LautiDO/Electro-FiubaRacing/raspi_config/Conexion SSH.pdf

1.- Ver conexiones de red-> Propiedades

2.- Editar TCP/IPV4

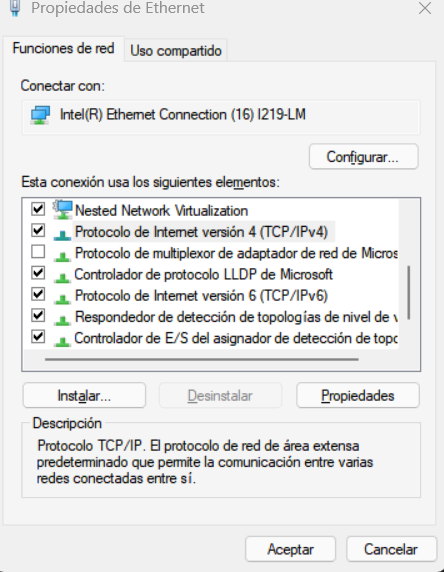
[picture p1: figure]

5.- Colocar las siguientes direcciones

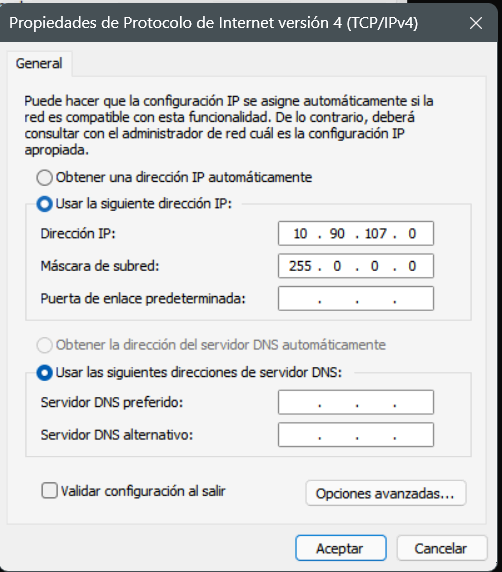
[picture p2: figure]

6.- realizar un ping para confirmar conexión

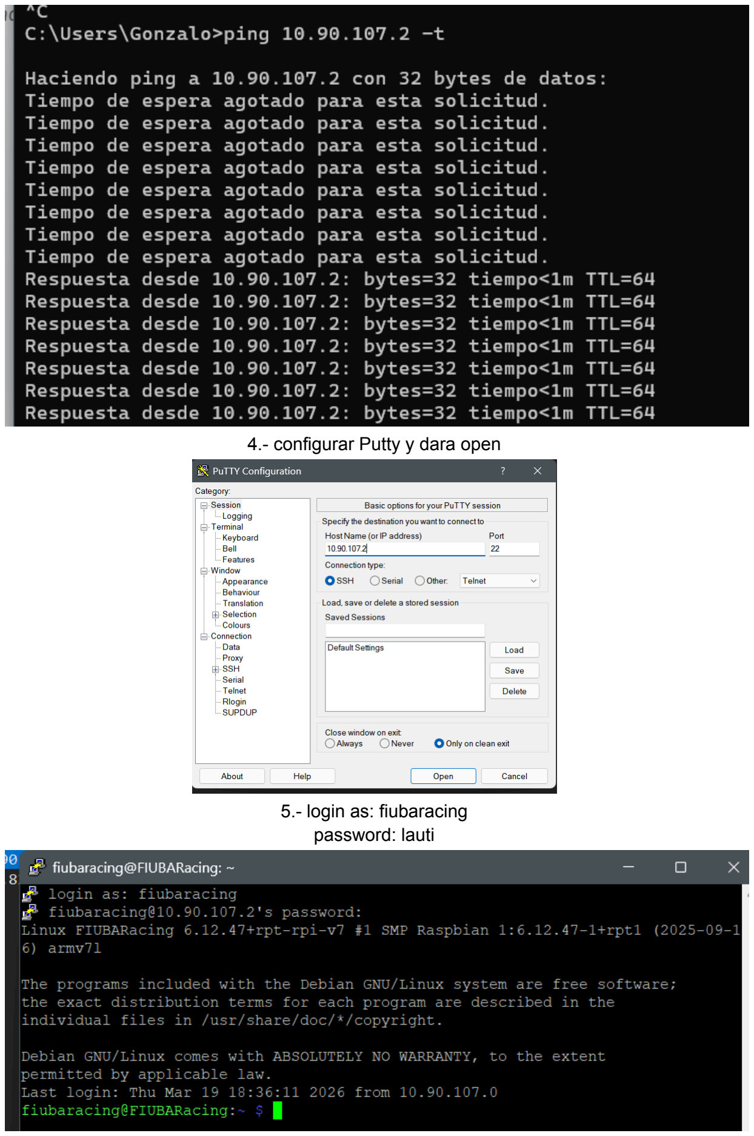
[picture p3: page 2]

4.- configurar Putty y dara open

5.- login as: fiubaracing
password: lauti
