LautiDO/Electro-FiubaRacing/PCB_V5/PCB_V5.kicad_pcb

## KiCad design PCB_V5/PCB_V5.kicad_pcb (2026-08-25)

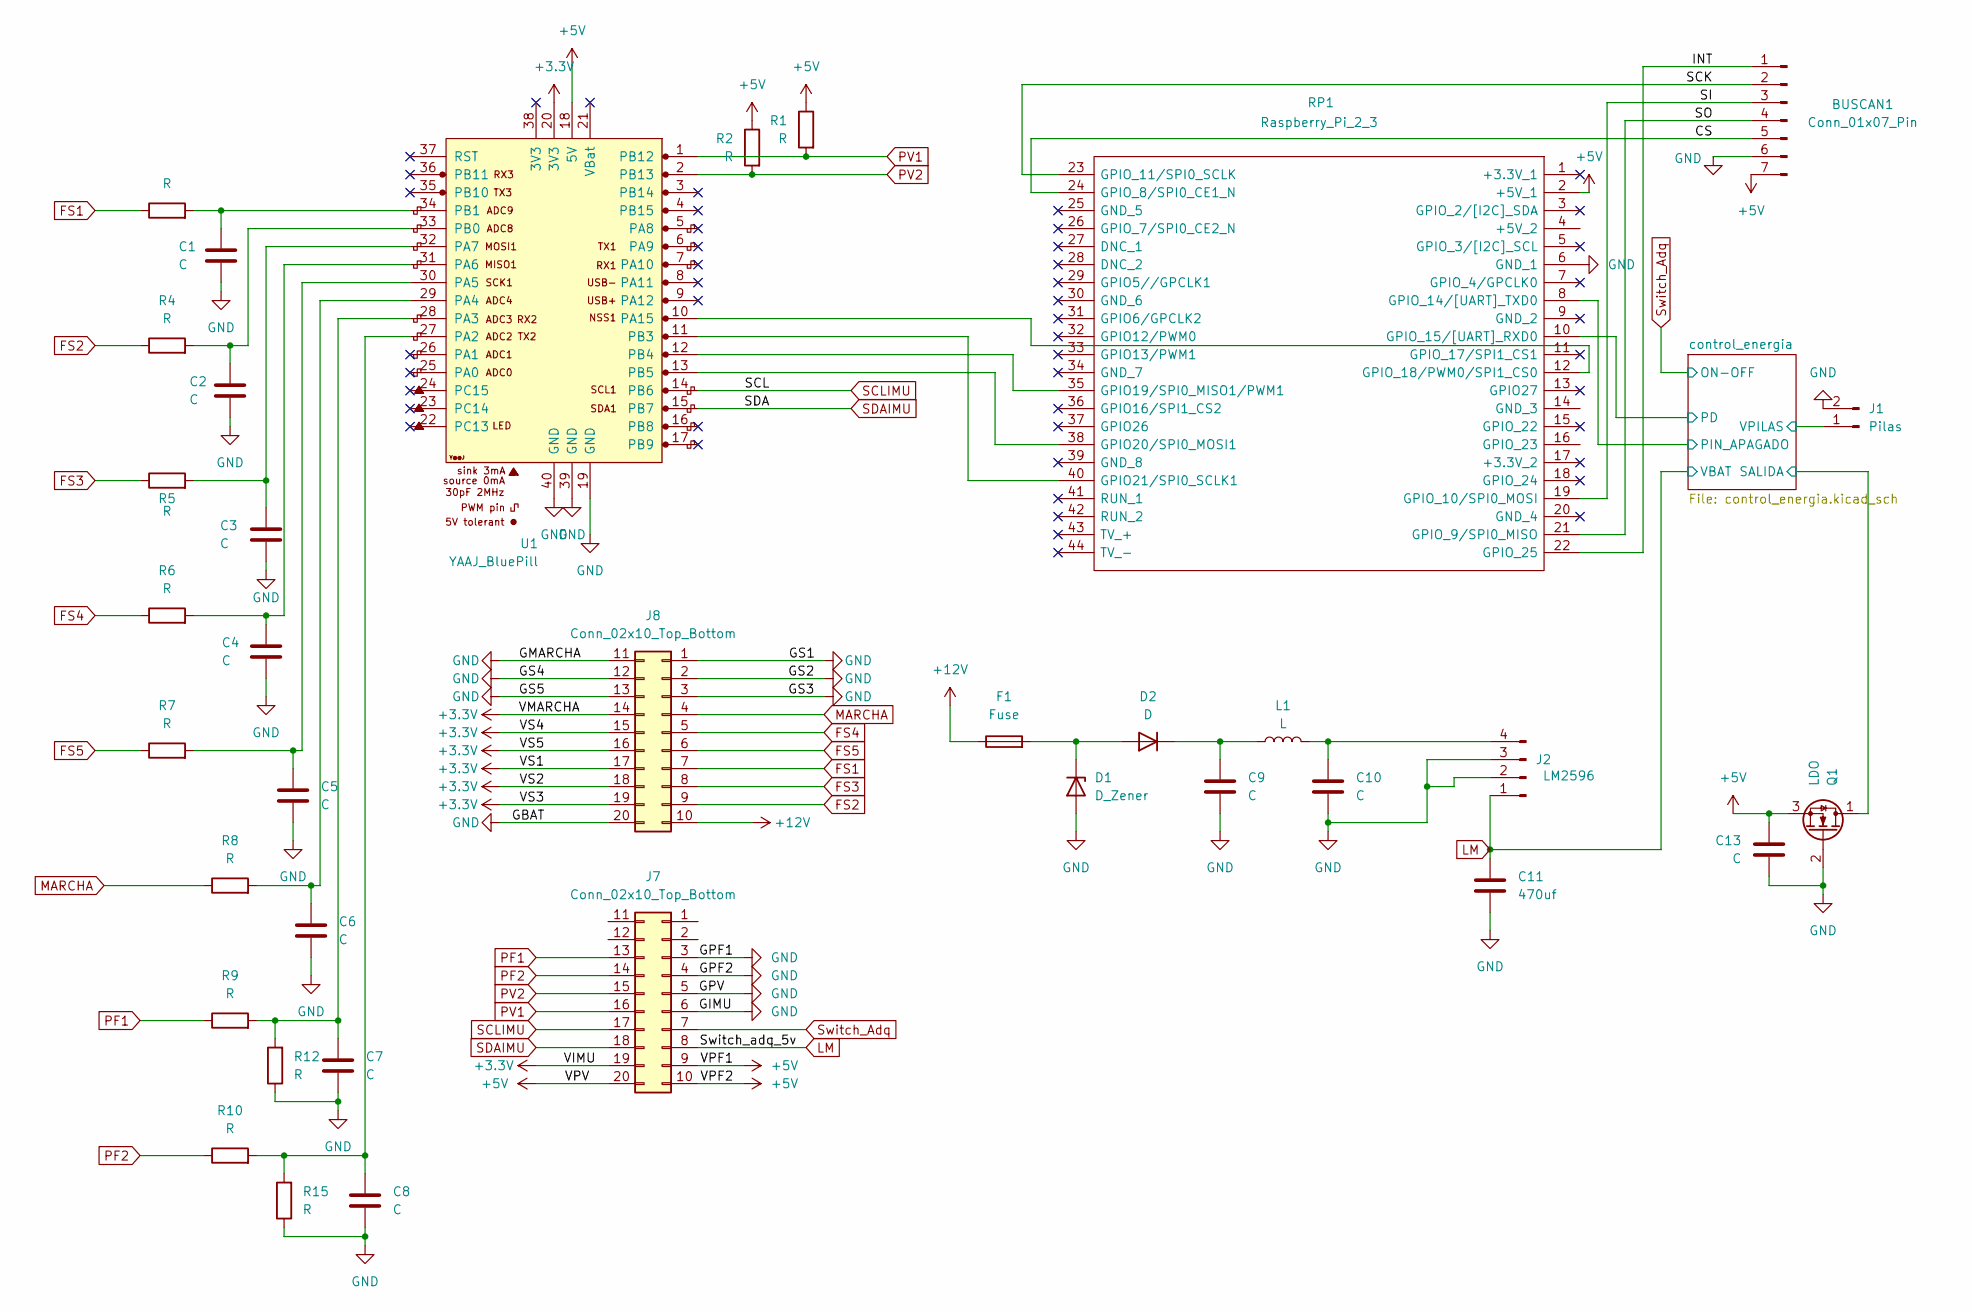
[picture p4: schematic PCB_V5.kicad_sch]

Parts:
BUSCAN1: Conn_01x07_Pin; PinHeader_1x07_P2.54mm_Vertical
C1, C2, C3, C4, C5, C6, C7, C8, C9, C10, C13: C; CP_Radial_D5.0mm_P2.50mm
C11: 470uf; CP_Radial_D5.0mm_P2.50mm
D1: D_Zener; D_DO-201_P15.24mm_Horizontal
D2: D; D_DO-201_P15.24mm_Horizontal
F1: Fuse; Fuseholder_Cylinder-5x20mm_Schurter_0031_8201_Horizontal_Op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
J1: Pilas; TerminalBlock_Phoenix_PT-1,5-2-5.0-H_1x02_P5.00mm_Horizontal
J2: LM2596; PinHeader_1x04_P2.54mm_Vertical
J7, J8: Conn_02x10_Top_Bottom; Molex_Mini-Fit_Jr_5566-20A2_2x10_P4.20mm_Vertical
L1: L; Transformer_CHK_EI38-3VA_Neutral
Q1: LDO; TO-220-3_Vertical
R1, R2, R3, R4, R5, R6, R7, R8, R9, R10, R12, R15: R; R_Axial_DIN0207_L6.3mm_D2.5mm_P7.62mm_Horizontal
RP1: Raspberry_Pi_2_3; PinHeader_2x20_P2.54mm_Vertical; Manufacturer_Part_Number Raspberry Pi 2 or 3
U1: YAAJ_BluePill; PinHeader_2x20_P2.54mm_Vertical

Connections:
+3.3V: J7.19, J8.14, J8.15, J8.16, J8.17, J8.18, J8.19, U1.20 (3V3)
+5V: BUSCAN1.7, C13.1, J7.9, J7.10, J7.20, Q1.3 (S), R1.1, R2.1, RP1.2 (+5V_1), U1.18 (5V)
+12V: F1.1, J8.10
/CS: BUSCAN1.5, RP1.24 (GPIO_8/SPI0_CE1_N)
/INT: BUSCAN1.1, RP1.22 (GPIO_25)
/SCK: BUSCAN1.2, RP1.23 (GPIO_11/SPI0_SCLK)
/SI: BUSCAN1.3, RP1.19 (GPIO_10/SPI0_MOSI)
/SO: BUSCAN1.4, RP1.21 (GPIO_9/SPI0_MISO)
/control_energia/PD: RP1.10 (GPIO_15/[UART]_RXD0); also elsewhere on the board
/control_energia/PIN_APAGADO: RP1.8 (GPIO_14/[UART]_TXD0); also elsewhere on the board
/control_energia/SALIDA: Q1.1 (D); also elsewhere on the board
/control_energia/VPILAS: J1.1; also elsewhere on the board
FS1: J8.7, R3.1
FS2: J8.9, R4.1
FS3: J8.8, R5.1
FS4: J8.5, R6.1
FS5: J8.6, R7.1
GND: BUSCAN1.6, C1.2, C2.2, C3.2, C4.2, C5.2, C6.2, C7.2, C8.2, C9.2, C10.2, C11.2, C13.2, D1.2 (A), J1.2, J2.2, J2.3, J7.3, J7.4, J7.5, J7.6, J8.1, J8.2, J8.3, J8.11, J8.12, J8.13, J8.20, Q1.2 (G), R12.1, R15.1, RP1.6 (GND_1), U1.19 (GND), U1.39 (GND), U1.40 (GND); also elsewhere on the board
LM: C11.1, J2.1, J7.8; also elsewhere on the board
MARCHA: J8.4, R8.1
unnamed: D1.1 (K), D2.2 (A), F1.2
unnamed: C9.1, D2.1 (K), L1.1
unnamed: C10.1, J2.4, L1.2
unnamed: RP1.35 (GPIO19/SPI0_MISO1/PWM1), U1.12 (PB4)
unnamed: RP1.38 (GPIO20/SPI0_MOSI1), U1.13 (PB5)
unnamed: RP1.40 (GPIO21/SPI0_SCLK1), U1.11 (PB3)
unnamed: RP1.12 (GPIO_18/PWM0/SPI1_CS0), U1.10 (PA15)
unnamed: C8.1, R10.2, R15.2, U1.27 (PA2)
unnamed: C7.1, R9.2, R12.2, U1.28 (PA3)
unnamed: C6.1, R8.2, U1.29 (PA4)
unnamed: C5.1, R7.2, U1.30 (PA5)
unnamed: C4.1, R6.2, U1.31 (PA6)
unnamed: C3.1, R5.2, U1.32 (PA7)
unnamed: C2.1, R4.2, U1.33 (PB0)
unnamed: C1.1, R3.2, U1.34 (PB1)
PF1: J7.13, R9.1
PF2: J7.14, R10.1
PV1: J7.16, R1.2, U1.1 (PB12)
PV2: J7.15, R2.2, U1.2 (PB13)
SCLIMU: J7.17, U1.14 (PB6)
SDAIMU: J7.18, U1.15 (PB7)
Switch_Adq: J7.7; also elsewhere on the board

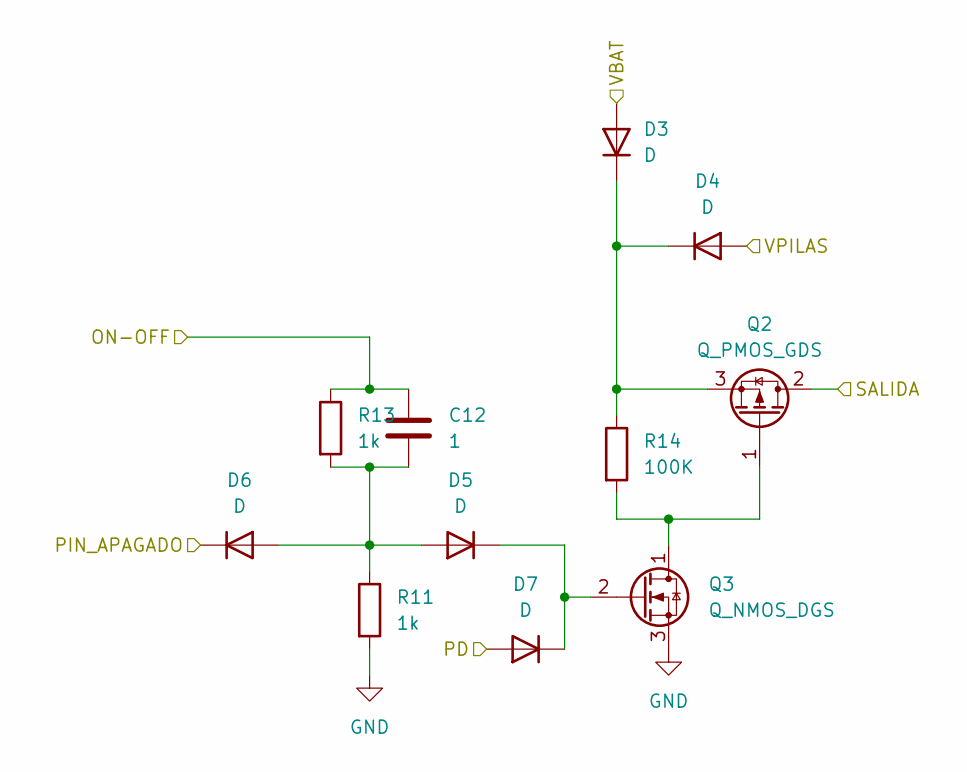
[picture p5: schematic control_energia.kicad_sch]

Parts:
C12: 1; CP_Radial_D5.0mm_P2.50mm
D3, D4, D5, D6, D7: D; R_Axial_DIN0207_L6.3mm_D2.5mm_P7.62mm_Horizontal
Q2: Q_PMOS_GDS; TO-220-3_Vertical
Q3: Q_NMOS_DGS; TO-92_HandSolder
R11, R13: 1k; R_Axial_DIN0207_L6.3mm_D2.5mm_P7.62mm_Horizontal
R14: 100K; R_Axial_DIN0207_L6.3mm_D2.5mm_P7.62mm_Horizontal

Connections:
/control_energia/PD: D7.2 (A); also elsewhere on the board
/control_energia/PIN_APAGADO: D6.1 (K); also elsewhere on the board
/control_energia/SALIDA: Q2.2 (D); also elsewhere on the board
/control_energia/VPILAS: D4.2 (A); also elsewhere on the board
GND: Q3.3 (S), R11.2; also elsewhere on the board
LM: D3.2 (A); also elsewhere on the board
unnamed: D3.1 (K), D4.1 (K), Q2.3 (S), R14.1
unnamed: C12.2, D5.2 (A), D6.2 (A), R11.1, R13.2
unnamed: D5.1 (K), D7.1 (K), Q3.2 (G)
unnamed: Q2.1 (G), Q3.1 (D), R14.2
Switch_Adq: C12.1, R13.1; also elsewhere on the board

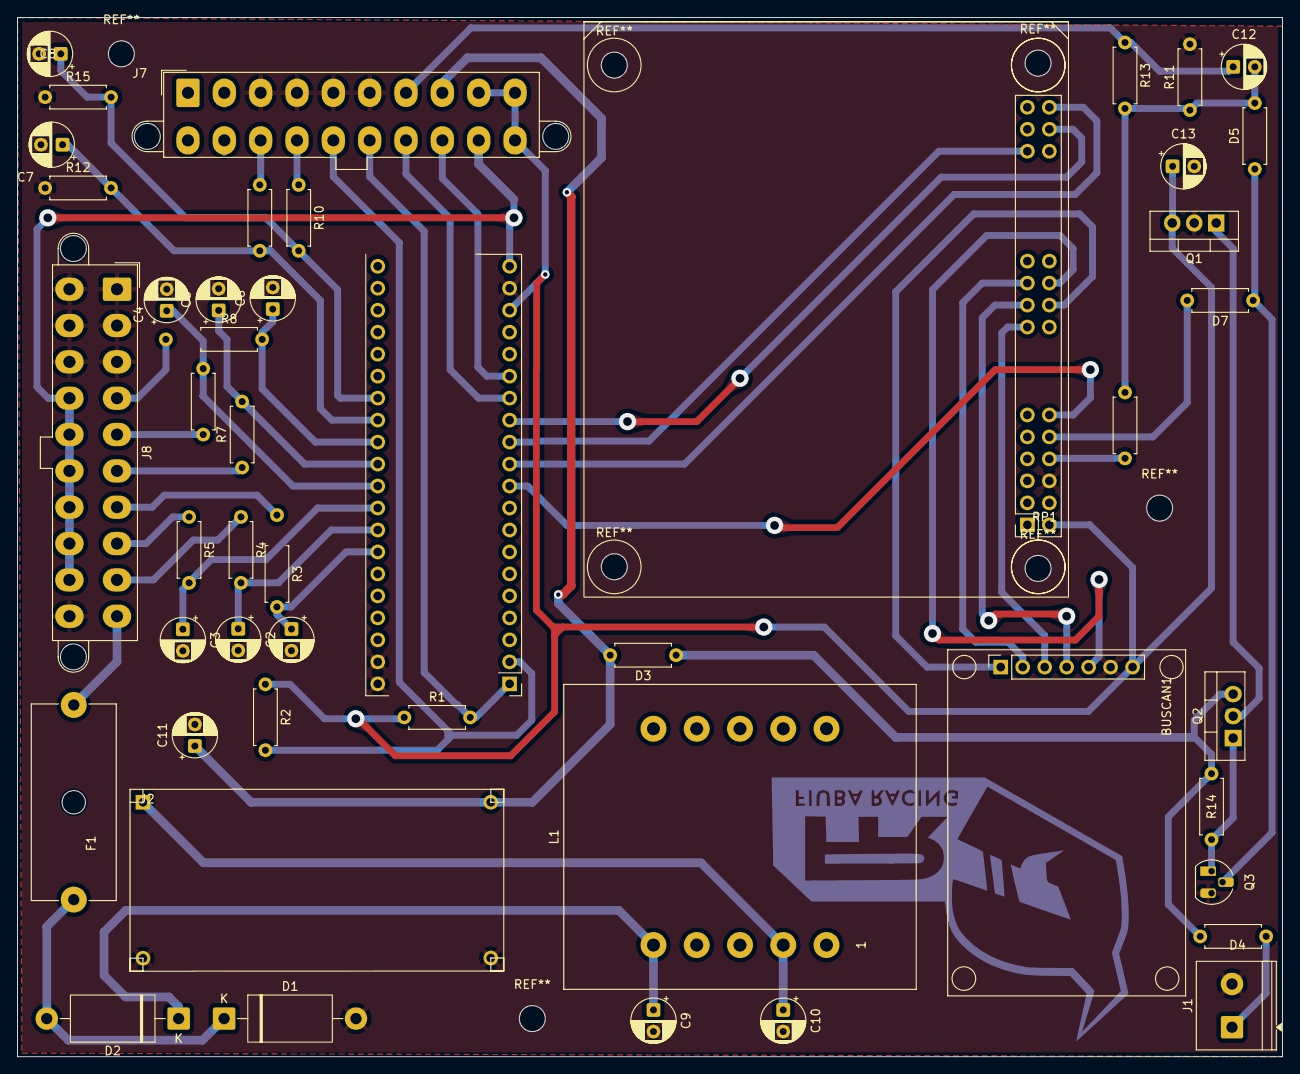
[picture p6: board PCB_V5.kicad_pcb from above]

Board: 2 copper layers, 146.2 x 120.1 mm, 47 parts (0 on the bottom side), 46 nets.
