LautiDO/Electro-FiubaRacing/adq_stm_v1/adq_stm_v1.ino

//====================================================
//                    LIBRERÍAS
//====================================================
#include <SPI.h>
#include <Adafruit_MPU6050.h>
#include <Adafruit_Sensor.h>
#include <VL53L0X.h>
#include <Wire.h>
#include <TinyGPS.h>



#include <libmaple/spi.h>
#include <libmaple/gpio.h>
#include <libmaple/rcc.h>
#include <libmaple/nvic.h>
//#include <libmaple/afio.h>


//====================================================
//           ENVÍO DE DATOS (SPI SLAVE)
//
//  Estructura del paquete (65 bytes) — SIN tiempo_us:
//  el Pi ya no necesita el reloj del STM32 porque pide muestras a
//  ritmo fijo (25 Hz) y las matchea con la ECU por estar en el mismo
//  ciclo, no por timestamp.
//  [0]      → 0xAA  (sync byte)
//  [1..4]   → angulo         (float, 4 bytes)
//  [5..8]   → acel_lateral   (float, 4 bytes)
//  [9..12]  → ax             (float, 4 bytes)  IMU cruda
//  [13..16] → ay             (float, 4 bytes)  IMU cruda
//  [17..20] → az             (float, 4 bytes)  IMU cruda
//  [21..24] → gx             (float, 4 bytes)  IMU cruda
//  [25..28] → gy             (float, 4 bytes)  IMU cruda
//  [29..32] → gz             (float, 4 bytes)  IMU cruda
//  [33..36] → dx1            (float, 4 bytes)
//  [37..40] → dx2            (float, 4 bytes)
//  [41..44] → dx3            (float, 4 bytes)
//  [45..48] → dx4            (float, 4 bytes)
//  [49..52] → dx5            (float, 4 bytes)
//  [53..56] → presion1       (float, 4 bytes)
//  [57..60] → presion2       (float, 4 bytes)
//  [61..64] → cambio         (int32_t, 4 bytes)
//  [65]     → checksum       (uint8_t, XOR de los bytes [1..64])
//====================================================
#define MAX_DATOS 66   // 1 sync + 15×4 float + 1×4 int32 (cambio) + 1 checksum

volatile uint8_t bufferActivo = 0;
uint8_t bufferEscritura = 1;
uint8_t misDatos[2][MAX_DATOS];

volatile int i_dato = 0;


//====================================================
//                      CAMBIOS
//====================================================

#define TOLERANCIA 25
#define NUM_CONFIRMACIONES 2   

int t1      = 3420;   // Primera
int t2      = 2980;   // Segunda
int t3      = 1976;   // Tercera
int t4      = 3959;   // Cuarta
int t5      = 3860;   // Quinta
int t6      = 3700;   // Sexta
int neutro  = 4095;   // Neutro
int pin_cambios = PA4;
int tolerancia = 40;
int cambio = 0;

int estado_actual = -1;         // último cambio CONFIRMADO
int candidato = -2;             // valor que se está evaluando
int contador_confirmacion = 0;  // cuántas veces seguidas se repitió el candidato 
  

//====================================================
//                      GPS
//====================================================
TinyGPS gps;
volatile bool newData = false;


//====================================================
//               EXTENSÓMETROS
//====================================================

#define NUM_EXTENSOMETROS 5

const float DMIN    =  0.0f;
const float DMAX    = 75.0f;
const float DFIJO   =  0.0f;
const float K_ELAST = 35.0f;



const int PIN_EXT1 = PA6;
const int PIN_EXT2 = PA5;
const int PIN_EXT3 = PB1;
const int PIN_EXT4 = PA3;
const int PIN_EXT5 = PB0;


//====================================================
//                      IMU
//====================================================
Adafruit_MPU6050 mpu;

bool     imu_online        = false;
uint32_t imu_ultimo_intento = 0;
const uint32_t IMU_REINTENTO_MS = 2000;

const float OFFSET_LATERAL = 0.06f;


//====================================================
//          ENCODER VOLANTE
//====================================================
const int PIN_ENCODER_A = PB12;
const int PIN_ENCODER_B = PB13;

volatile long pulsos         = 0;
         long pulsos_anterior = 0;

float angulo = 0.0f;  
const float FACTOR_CONVERSION = 0.6f;


//====================================================
//                      IMU
//====================================================

//====================================================
//                      PRESIONES
//====================================================


int pin_presion1 = PA1;
int pin_presion2 = PA2;




//====================================================
//                      SETUP
//====================================================
void setup() {
  Serial.begin(115200);
  Serial3.begin(9600);

  pinMode(PIN_ENCODER_A, INPUT_PULLUP);
  pinMode(PIN_ENCODER_B, INPUT_PULLUP);
  attachInterrupt(digitalPinToInterrupt(PIN_ENCODER_A), encoderISR, FALLING);

  Wire.begin();
  //Wire.setSCLTimeout(100);
//  intentarConectarIMU();

  configurarSPISlave();
  Serial.println("[OK] SPI Slave configurado.");

  memset(misDatos, 0, sizeof(misDatos));
  Serial.println("[OK] Setup completo. Iniciando adquisicion...");
}


//====================================================
//                      LOOP
//====================================================
const uint32_t PERIODO_MUESTREO_US = 20000; // 20.000 us = 50 Hz FIX ACA, TENIAN UN 0 DE MAS
uint32_t tiempo_previo_us = 0;


void loop() {
  uint32_t tiempo_actual = micros();

  // Ejecuta la adquisición estrictamente cada 20 ms (50 Hz)
  if (tiempo_actual - tiempo_previo_us >= PERIODO_MUESTREO_US) {
    tiempo_previo_us += PERIODO_MUESTREO_US;

    //--- Reconexión IMU (no bloquea) ------------------
    if (!imu_online) {
      uint32_t ahora = millis();
      if (ahora - imu_ultimo_intento >= IMU_REINTENTO_MS) {
        imu_ultimo_intento = ahora;
        intentarConectarIMU();
      }
    }
 
    //--- Extensómetros --------------------------------
    float dx1 = leerExtensometro(PIN_EXT1, 0);
    float dx2 = leerExtensometro(PIN_EXT2, 1);
    float dx3 = leerExtensometro(PIN_EXT3 , 2);
    /*
    float dx4 = leerExtensometro(PIN_EXT4);
    float dx5 = leerExtensometro(PIN_EXT5);
    */
  
   // float dx2 = 1;
    //float dx3 = 2;
    float dx4 = 3;
    float dx5 = 4;
    //--- PRESION ------------------------------------------
  
    uint16_t cambio_adc = analogRead(pin_cambios);
    
  
    int cambio_confirmado = leer_cambio_confirmado(cambio_adc);
  
    
  
      
    //int cambio = leer_cambio(pin_cambios);
  
    //Serial.print(valor);
    
    //int cambio = 4;
    //--- PRESION ------------------------------------------
  
    float presion1 = leer_presion(pin_presion1);
    float presion2 = leer_presion(pin_presion2);
  
  
  
  
  //--- IMU ------------------------------------------

    float acel_lateral_g = 0.0f;
    float acel_long_g = 0.0f;
    float magnitud_g = 0.0f;
    float angulo_vector = 0.0f;

    // Valores crudos del MPU6050, se envían por SPI además de acel_lateral_g.
    // Quedan en 0 si la IMU no está online (misma convención que acel_lateral_g).
    float ax = 0.0f, ay = 0.0f, az = 0.0f;
    float gx = 0.0f, gy = 0.0f, gz = 0.0f;

    if (imu_online) {
      if (imuResponde()) {
        sensors_event_t a, g, temp;
        mpu.getEvent(&a, &g, &temp);
        
        // La función actualiza directamente acel_lateral_g y acel_long_g
        calcularFuerzasG(a.acceleration.x, a.acceleration.y, a.acceleration.z, acel_lateral_g, acel_long_g);
        
        // Magnitud total (radio del vector)
        magnitud_g = sqrtf(acel_lateral_g * acel_lateral_g + acel_long_g * acel_long_g);
        
        // Dirección del vector en grados (de -180 a 180)
        angulo_vector = atan2f(acel_lateral_g, acel_long_g) * 180.0f / PI;

        // Valores crudos de acelerómetro y giróscopo (para SPI + debug)
        ax = a.acceleration.x;
        ay = a.acceleration.y;
        az = a.acceleration.z;
        gx = g.gyro.x;
        gy = g.gyro.y;
        gz = g.gyro.z;

        // Impresión para el monitor/graficador
        
        Serial.print("Magnitud:"); Serial.print(magnitud_g); Serial.print(" ");
        Serial.print("Angulo:"); Serial.print(angulo_vector);

        // Debug de valores crudos IMU
        Serial.print("ax="); Serial.print(a.acceleration.x); Serial.print(", ");
        Serial.print("ay="); Serial.print(a.acceleration.y); Serial.print(", ");
        Serial.print("az="); Serial.print(a.acceleration.z); Serial.print(", ");

        // Valores del giroscopio
        Serial.print("gx="); Serial.print(g.gyro.x); Serial.print(", ");
        Serial.print("gy="); Serial.print(g.gyro.y); Serial.print(", ");
        Serial.print("gz="); Serial.println(g.gyro.z);

      } else {
        imu_online = false;
        Serial.println("[IMU] Desconexion detectada. Reintentando en 2 s...");
      }
    }


     


    if (imu_online) {
      if (imuResponde()) {
        sensors_event_t a, g, temp;
        mpu.getEvent(&a, &g, &temp);
        acel_lateral_g = calcularAceleracionLateral(
          a.acceleration.x, a.acceleration.y, a.acceleration.z
        );
      } else {
        imu_online = false;
        Serial.println("[IMU] Desconexion detectada. Reintentando en 2 s...");
      }
    }

    //--- Encoder --------------------------------------
    noInterrupts();
    long copia_pulsos = pulsos;
    interrupts();
    if (copia_pulsos != pulsos_anterior) {
      angulo          = copia_pulsos * FACTOR_CONVERSION;
      pulsos_anterior = copia_pulsos;
    }
  
  
    //--- Armar y publicar paquete SPI -----------------
    armarPaquete(angulo, acel_lateral_g, ax, ay, az, gx, gy, gz,
                 dx1, dx2, dx3, dx4, dx5, cambio_confirmado, presion1, presion2);

    // El swap de buffer y el reset de i_dato tienen que pasar juntos, sin que
    // la ISR de SPI pueda meterse en el medio. Si no, la ISR puede seguir
    // mandando bytes del índice viejo pero ya apuntando al buffer nuevo →
    // frame desalineado (el "ruido" con picos que se ve en la Raspberry).
    // Al resetear i_dato acá, forzamos que la PRÓXIMA transferencia (o el
    // resto de la actual) vuelva a arrancar desde el byte 0xAA de sync,
    // en vez de arrastrar el offset viejo sobre datos nuevos.
    noInterrupts();
    bufferActivo    = bufferEscritura;
    bufferEscritura = 1 - bufferActivo;
    i_dato = 0;
    SPI1->regs->DR = misDatos[bufferActivo][0];
    interrupts();
  
    //--- Debug serial ---------------------------------
    
   // Serial.print("Angulo:"); Serial.print(angulo, 1); Serial.print(" ");
    Serial.print("dx1:"); Serial.print(dx1, 1); Serial.print(" | ");
    Serial.print("dx2:"); Serial.print(dx2, 1); Serial.print(" | ");
    Serial.print("dx3:"); Serial.print(dx3, 1); Serial.print(" | ");
  //  Serial.print("FuerzaG:"); Serial.print(acel_lateral_g);              // <-- Etiqueta unida y con ':'
    Serial.print("cambio="); Serial.print(cambio_confirmado);
  //  Serial.print("°  cambio adc=");Serial.print(cambio_adc);
   // Serial.print("presion1="); Serial.println(presion1);
    //Serial.print("presion2="); Serial.println(presion2, 1);
    Serial.println();
  }
}




//====================================================
//         CONFIGURACIÓN SPI SLAVE
//====================================================
/*
void configurarSPISlave() {
  rcc_clk_enable(RCC_SPI1);
  rcc_clk_enable(RCC_GPIOA);

  gpio_set_mode(GPIOA, 4, GPIO_INPUT_FLOATING);  // NSS
  gpio_set_mode(GPIOA, 5, GPIO_INPUT_FLOATING);  // SCK
  gpio_set_mode(GPIOA, 7, GPIO_INPUT_FLOATING);  // MOSI
  gpio_set_mode(GPIOA, 6, GPIO_AF_OUTPUT_PP);    // MISO

  SPI1->regs->CR1  = 0;
  SPI1->regs->CR2 |= SPI_CR2_RXNEIE;
  SPI1->regs->CR1 |= SPI_CR1_SPE;

  SPI1->regs->DR = misDatos[bufferActivo][0];
  nvic_irq_enable(NVIC_SPI1);
}
*/

void configurarSPISlave() {
  // 1. Habilitar relojes
  rcc_clk_enable(RCC_SPI1);
  rcc_clk_enable(RCC_GPIOA);
  rcc_clk_enable(RCC_GPIOB);
  rcc_clk_enable(RCC_AFIO); 

  // 2. Liberar pines JTAG (PA15, PB3, PB4) para que funcionen como SPI
  // Esto es CRÍTICO para que el micro no ignore estos pines
  afio_cfg_debug_ports(AFIO_DEBUG_SW_ONLY);

  // 3. Activar el Remap usando la constante correcta de libmaple
  afio_remap(AFIO_REMAP_SPI1); 

  // 4. Configurar los NUEVOS pines según el Remap de SPI1
  // NSS: PA15 | SCK: PB3 | MISO: PB4 | MOSI: PB5
  gpio_set_mode(GPIOA, 15, GPIO_INPUT_FLOATING); 
  gpio_set_mode(GPIOB, 3, GPIO_INPUT_FLOATING);  
  gpio_set_mode(GPIOB, 5, GPIO_INPUT_FLOATING);  
  gpio_set_mode(GPIOB, 4, GPIO_AF_OUTPUT_PP);    

  // 5. Configuración de registros SPI (igual que antes)
  SPI1->regs->CR1  = 0;
  SPI1->regs->CR2 |= SPI_CR2_RXNEIE;
  SPI1->regs->CR1 |= SPI_CR1_SPE;

  // Cargar primer byte
  SPI1->regs->DR = misDatos[bufferActivo][0];
  nvic_irq_enable(NVIC_SPI1);
}


//====================================================
//         ISR — SPI1
//====================================================
extern "C" void __irq_spi1() {
  if (SPI1->regs->SR & SPI_SR_RXNE) {
    (void)SPI1->regs->DR;
    i_dato++;
    if (i_dato >= MAX_DATOS) i_dato = 0;
    SPI1->regs->DR = misDatos[bufferActivo][i_dato];
  }
}


//====================================================
//              FUNCIONES AUXILIARES
//====================================================

void armarPaquete(float ang, float acel,
                  float ax, float ay, float az,
                  float gx, float gy, float gz,
                  float dx1, float dx2, float dx3, float dx4, float dx5, int cambio,
                  float presion1, float presion2) {
  uint8_t* buf = misDatos[bufferEscritura];
  int pos = 0;

  buf[pos++] = 0xAA;
  memcpy(&buf[pos], &ang,  4); pos += 4;
  memcpy(&buf[pos], &acel, 4); pos += 4;
  memcpy(&buf[pos], &ax,   4); pos += 4;
  memcpy(&buf[pos], &ay,   4); pos += 4;
  memcpy(&buf[pos], &az,   4); pos += 4;
  memcpy(&buf[pos], &gx,   4); pos += 4;
  memcpy(&buf[pos], &gy,   4); pos += 4;
  memcpy(&buf[pos], &gz,   4); pos += 4;
  memcpy(&buf[pos], &dx1,  4); pos += 4;
  memcpy(&buf[pos], &dx2,  4); pos += 4;
  memcpy(&buf[pos], &dx3,  4); pos += 4;
  memcpy(&buf[pos], &dx4,  4); pos += 4;
  memcpy(&buf[pos], &dx5,  4); pos += 4;
  memcpy(&buf[pos], &presion1,  4); pos += 4;
  memcpy(&buf[pos], &presion2,  4); pos += 4;
  memcpy(&buf[pos], &cambio,  4); pos += 4; // pos = 65

  // Checksum simple (XOR de todos los bytes de datos, sin contar el sync).
  // La Pi lo recalcula y descarta el frame entero si no coincide — así un
  // frame que haya quedado desalineado/torn se detecta con certeza en vez
  // de decodificarse como si fueran floats válidos.
  uint8_t chk = 0;
  for (int j = 1; j < pos; j++) chk ^= buf[j];
  buf[pos] = chk; // pos = 65 → byte [65]
}

void intentarConectarIMU() {
  imu_ultimo_intento = millis();
  if (mpu.begin()) {
    mpu.setAccelerometerRange(MPU6050_RANGE_8_G);
    mpu.setGyroRange(MPU6050_RANGE_500_DEG);
    mpu.setFilterBandwidth(MPU6050_BAND_44_HZ);
    imu_online = true;
    Serial.println("[IMU] Conectada.");
  } else {
    imu_online = false;
    Serial.println("[IMU] No responde. Reintento en 2 s...");
  }
}



bool imuResponde() {
  Wire.beginTransmission(0x68);
  Wire.write(0x75);
  if (Wire.endTransmission(false) != 0) return false;
  Wire.requestFrom(0x68, 1);
  if (!Wire.available()) return false;
  return (Wire.read() == 0x68);
}
/*
float leerExtensometro(int pin) {
  int raw    = analogRead(pin);
  float dmed = DMIN + (DMAX - DMIN) * (float)(4095 - raw) / 4095.0f;
  return dmed - DFIJO;
}
*/

float OFFSET_LONGITUDINAL = 0;




void calcularFuerzasG(float Ax, float Ay, float Az, float &lat, float &lon) {
  // 1. Calcular inclinación (pitch y roll) usando tu lógica
  float pitch = atan2f(-Ax, sqrtf(Ay * Ay + Az * Az));
  float roll  = atan2f(Ay, Az);
  
  // 2. Calcular cuánta gravedad afecta a cada eje por la inclinación
  float gy = 9.81f * sinf(roll) * cosf(pitch);
  float gx = 9.81f * sinf(pitch); 
  
  // 3. Restar la gravedad para obtener la aceleración lineal pura
  float ay_lin = Ay - gy;
  float ax_lin = Ax - gx;
  
  // 4. Convertir a Gs y restar tu offset
  lat = (ay_lin / 9.81f) - OFFSET_LATERAL;

  lon = (ax_lin / 9.81f) - OFFSET_LONGITUDINAL; 
}







float leerExtensometro(int pin, int id) {
    const float ALPHA = 0.5; //FIX ACA PROBANDO CON ALFA MAS CHICO PARA VER SI ELIMINA LOS PICOS
    static float filtrado[NUM_EXTENSOMETROS] = {0};
    static int inicializado[NUM_EXTENSOMETROS] = {0};

    int raw = analogRead(pin);

    // Primera lectura: inicializa sin rampa de subida
    if (!inicializado[id]) {
        filtrado[id] = (float)raw;
        inicializado[id] = 1;
    } else {
        filtrado[id] += ALPHA * ((float)raw - filtrado[id]);
    }

    float dmed = DMIN + (DMAX - DMIN) * (4095.0f - raw)/4095.0f;//filtrado[id]) / 4095.0f;
    return dmed ;//- DFIJO;
}

float calcularAceleracionLateral(float Ax, float Ay, float Az) {
  float pitch  = atan2f(-Ax, sqrtf(Ay * Ay + Az * Az));
  float roll   = atan2f(Ay, Az);
  float gy     = 9.81f * sinf(roll) * cosf(pitch);
  float ay_lin = Ay - gy;
  return (ay_lin / 9.81f) - OFFSET_LATERAL;
}

void encoderISR() {
  if (digitalRead(PIN_ENCODER_B) == HIGH) pulsos++;
  else                                    pulsos--;
}

bool esTransicionValida(int desde, int hacia) {
  if (desde == -1) return true;   // arranque, estado desconocido: acepta el primero
  if (desde == hacia) return true;
  switch (desde) {
    case 0: return (hacia == 1 || hacia == 2);               // Neutro <-> 1ra o 2da
    case 1: return (hacia == 0 || hacia == 2);               // 1ra <-> N o 2da
    case 2: return (hacia == 0 || hacia == 1 || hacia == 3); // 2da <-> N, 1ra o 3ra
    case 3: return (hacia == 2 || hacia == 4);
    case 4: return (hacia == 3 || hacia == 5);
    case 5: return (hacia == 4 || hacia == 6);
    case 6: return (hacia == 5);
    default: return false;
  }
}




int clasificar_lectura(int valor) {
  if (valor >= (t1 - TOLERANCIA) && valor <= (t1 + TOLERANCIA)) return 1;
  if (valor >= (t2 - TOLERANCIA) && valor <= (t2 + TOLERANCIA)) return 2;
  if (valor >= (t3 - TOLERANCIA) && valor <= (t3 + TOLERANCIA)) return 3;
  if (valor >= (t4 - TOLERANCIA) && valor <= (t4 + TOLERANCIA)) return 4;
  if (valor >= (t5 - TOLERANCIA) && valor <= (t5 + TOLERANCIA)) return 5;
  if (valor >= (t6 - TOLERANCIA) && valor <= (t6 + TOLERANCIA)) return 6;
  if (valor >= (neutro - TOLERANCIA) && valor <= (neutro + TOLERANCIA))return 0;
  return -1; //   en tránsito, no matchea ninguna
}


int leer_cambio_confirmado(int valor_adc) {
  int lectura = clasificar_lectura(valor_adc);

  if (lectura == -1) {
    // en tránsito: se resetea el conteo, no se confirma nada
    contador_confirmacion = 0;
    candidato = -2;
    return estado_actual;
  }

  if (lectura == candidato) {
    contador_confirmacion++;
  } else {
    candidato = lectura;
    contador_confirmacion = 1;
  }

  if (contador_confirmacion >= NUM_CONFIRMACIONES) {
    if (esTransicionValida(estado_actual, candidato)) {
      estado_actual = candidato;
    }
    // si no es vecino válido, se descarta como ruido y se mantiene estado_actual
  }

  return estado_actual;
}



float leer_presion(int pin_presion){
  float presion = analogRead(pin_presion);
  return presion;
  }
