LautiDO/Electro-FiubaRacing/telemetria_simple_v26.py

#!/usr/bin/env python3
"""
TELEMETRÍA UNIFICADA v3 — Raspberry Pi

Fuentes:
  STM32 → SPI     (marcha, ángulo, acel_lateral, accel xyz, giro xyz, dx1..dx3, presiones STM)
  ECU   → Serial  (RPM, TPS, AFR, temperaturas, batería) — hilo propio, sticky
  GPS   → CAN RX  (latitud, longitud, velocidad)
  Neumáticos → CAN RX (temperatura, 4 ruedas: 0x3F0 DI, 0x3F4 DD, 0x3F8 TI, 0x3FC TD)
Salidas:
  CAN TX    → hilo propio, 10 Hz, manda el último estado sticky a la pantalla del cockpit
  CSV       → hilo propio con cola, no bloquea nada
  Consola   → hilo propio, debug local en la Raspberry
"""

import can, spidev, serial, struct, csv, time, os, threading, queue, math
from collections import deque
from datetime import datetime

# =============================================================
# FLAGS DE PRUEBA (editar acá)
# =============================================================

# True  → hilo de consola activo, se arma y se imprime el panel de debug.
# False → no se crea el hilo de consola ni se arma el estado para mostrar (ahorra CPU).
#         Los mensajes de arranque/error de los hilos ([ECU], [CSV], etc.) siguen saliendo.
MOSTRAR_CONSOLA = True

# Constante de tiempo del filtro de la temperatura del refrigerante, en segundos.
# Más grande = más suave pero más lento en reflejar cambios reales.
# 0 = filtro desactivado (se guarda el valor crudo).
TEMP_REFRIG_TAU_S = 3.0

# =============================================================
# CONFIGURACIÓN
# =============================================================

CICLO_S = 0.04        # 25 Hz — loop principal (SPI + armado de fila CSV)
DISPLAY_HZ = 10        # refresco de la consola LOCAL de la Raspberry (debug)
DISPLAY_PERIODO_S = 1.0 / DISPLAY_HZ

CAN_TX_PERIODO_S = 0.1  # 10 Hz — cadencia del hilo que manda datos a la pantalla del cockpit

# --- SPI (STM32) ---
SPI_BUS, SPI_DEVICE = 1, 0
SPI_VELOCIDAD = 100_000
SPI_MODO = 0b00
STM32_SYNC = 0xAA

STM32_TAM_PKT = 62        # 1 sync + 2 contador + 13 floats + 1 int32 (cambio) + 2 contador + 1 checksum
STM32_FORMATO = '<H13fiH' # little-endian: contador, 13 floats, cambio, contador repetido

# Lectura doble: el STM repite la trama en bucle mientras dure el CS, así que en una
# ventana de 2 tramas siempre hay al menos una completa, aunque llegue corrida.
STM32_TAM_LECTURA = STM32_TAM_PKT * 2   # 124 bytes por transacción

# Si fallan tantas lecturas seguidas (25 ciclos = 1 s) se cierra y reabre el dispositivo SPI.
SPI_FALLOS_PARA_REABRIR = 25
# Reintento inmediato dentro del mismo ciclo cuando una lectura falla (pausa en segundos).
SPI_REINTENTO_PAUSA_S = 0.008   # el STM necesita unos ms para cerrar la transacción anterior (polling de CS)

# Códigos de comando que entiende el firmware del STM32
CMD_STM_OFFSET_LONG  = 1  # parámetro: offset longitudinal en milésimas de g
CMD_STM_CERO_VOLANTE = 2  # sin parámetro: pone el ángulo del volante en cero
CMD_STM_DMAX         = 3  # parámetro: DMAX de los extensómetros en décimas de mm

# --- Diagnóstico SPI ---
# El STM genera una muestra cada 20 ms y la Raspi lee cada CICLO_S, así que entre dos lecturas
# válidas el contador avanza ~CICLO_S/0.02 (=2 a 25 Hz). Más que este delta se cuenta como "salto".
STM_DELTA_CNT_MAX = 4
# True → cada trama fallida se agrega completa (hex) a un archivo, para analizarla después.
SPI_DUMP_FALLOS = True
SPI_DUMP_MAX = 500              # tope de tramas volcadas por sesión
SPI_DUMP_BYTES_CONSOLA = 8      # cuántos bytes de la última trama fallida se muestran en consola

# --- ECU (Serial) ---
ECU_PUERTO    = "/dev/ttyUSB0"
ECU_BAUDRATE  = 115200
ECU_HEADER    = b'\xFF\x7F'
ECU_FOOTER    = b'\x7F\xFF'

ECU_PERIODO_S        = 0.04   # 25 Hz — cada cuánto se reenvía el pedido a la ECU
ECU_RETRY_ESPERA      = 3.0   # segundos entre reintentos de apertura del puerto
ECU_BUFFER_MAX        = 2048  # tope de bytes en buffer sin lograr sync
ECU_RESYNC_TIMEOUT_S  = 2.0   # si no se arma un frame válido en este tiempo, se purga el buffer
ECU_OK_TIMEOUT_S      = 1.0   # si no hay frame ECU válido en este tiempo, se muestra como "SIN DATOS"

# --- CAN ---
CAN_CANAL   = 'can0'
CAN_BITRATE = 1_000_000

CAN_ID_MOTOR       = 0x640
CAN_ID_PRES_ACEITE = 0x644
CAN_ID_TEMPS       = 0x649
CAN_ID_MARCHA      = 0x64D
CAN_ID_LAMBDA      = 0x460

CAN_ID_GPS_LATLON  = 0x680
CAN_ID_GPS_TIEMPO  = 0x681
CAN_ID_GPS_FECHA   = 0x682

CAN_ID_NEUMATICO_DI = 0x3F0  # Delantera izquierda
CAN_ID_NEUMATICO_DD = 0x3F4  # Delantera derecha
CAN_ID_NEUMATICO_TI = 0x3F8  # Trasera izquierda
CAN_ID_NEUMATICO_TD = 0x3FC  # Trasera derecha

SIG_RPM         = {'off': 0, 'len': 2, 'mask': 0xFFFF, 'mult': 1,    'div': 1,    'add': 0}
SIG_TPS         = {'off': 6, 'len': 2, 'mask': 0xFFFF, 'mult': 1,    'div': 10,   'add': 0}
SIG_PRES_ACEITE = {'off': 6, 'len': 2, 'mask': 0xFFFF, 'mult': 1000, 'div': 1,    'add': 0}
SIG_TEMP_REFRIG = {'off': 0, 'len': 1, 'mask': 0xFF,   'mult': 1,    'div': 1,    'add': 40}
SIG_TEMP_AIRE   = {'off': 1, 'len': 1, 'mask': 0xFF,   'mult': 1,    'div': 1,    'add': 40}
SIG_MARCHA      = {'off': 6, 'len': 1, 'mask': 0x0F,   'mult': 1,    'div': 1,    'add': 0}
SIG_BATERIA     = {'off': 5, 'len': 1, 'mask': 0xFF,   'mult': 1,    'div': 10,   'add': 0}
SIG_LAMBDA      = {'off': 0, 'len': 2, 'mask': 0xFFFF, 'mult': 1000, 'div': 1,    'add': 0}

# --- CSV ---
CSV_DIR = os.path.join(os.path.dirname(os.path.abspath(__file__)), "sesiones")
os.makedirs(CSV_DIR, exist_ok=True)

def _nombre_csv_unico():
    base = datetime.now().strftime('%Y%m%d_%H-%M-%S')
    candidato = os.path.join(CSV_DIR, f"sesion_{base}.csv")
    n = 1
    while os.path.exists(candidato):
        candidato = os.path.join(CSV_DIR, f"sesion_{base}_{n}.csv")
        n += 1
    return candidato

CSV_NOMBRE = _nombre_csv_unico()
SPI_DUMP_NOMBRE = CSV_NOMBRE.replace(".csv", "_spi_fallos.log")
FSYNC_CADA_S = 0.5

CSV_COLUMNAS = [
    "tiempo_pc_ms",
    "marcha", "angulo", "acel_lateral",
    "acel_x", "acel_y", "acel_z",
    "giro_x", "giro_y", "giro_z",
    "dx1", "dx2", "dx3",
    "stm_presion1", "stm_presion2",
    "rpm", "tps", "afr",
    "temp_refrigerante", "temp_aire",
    "presion_aceite", "bateria_v",
    "gps_lat", "gps_lon", "gps_vel_kmh",
    "temp_neumatico_di", "temp_neumatico_dd", "temp_neumatico_ti", "temp_neumatico_td",
]

STM_CAMPOS = ["marcha", "angulo", "acel_lateral", "acel_x", "acel_y", "acel_z",
              "giro_x", "giro_y", "giro_z", "dx1", "dx2", "dx3",
              "stm_presion1", "stm_presion2"]
ECU_CAMPOS = ["rpm", "tps", "afr", "temp_refrigerante", "temp_aire",
              "presion_aceite", "bateria_v"]
GPS_CAMPOS = ["gps_lat", "gps_lon", "gps_vel_kmh"]
NEUMATICO_CAMPOS = ["temp_neumatico_di", "temp_neumatico_dd", "temp_neumatico_ti", "temp_neumatico_td"]

NOMBRES_MARCHA = {0: "N", 1: "1ª", 2: "2ª", 3: "3ª", 4: "4ª", 5: "5ª", 6: "6ª"}

# --- Colores / formato consola (ANSI) ---
RESET    = "\033[0m"
BOLD     = "\033[1m"
CYAN     = "\033[36m"
AZUL     = "\033[34m"
VERDE    = "\033[32m"
AMARILLO = "\033[33m"
ROJO     = "\033[31m"
GRIS     = "\033[90m"
CLEAR    = "\033[2J\033[H"

def _fmt(val, decimales=2):
    """Formatea un valor numérico, o '---' si todavía no hay dato."""
    if val is None:
        return f"{GRIS}---{RESET}"
    return f"{val:.{decimales}f}"

def _fmt_neumatico(temp, decimales=1):
    """Temperatura de neumático con color según rango (azul frío, verde ok, amarillo caliente, rojo crítico)."""
    if temp is None:
        return f"{GRIS}---{RESET}"
    if temp < 30:
        color = AZUL
    elif temp < 75:
        color = VERDE
    elif temp < 90:
        color = AMARILLO
    else:
        color = ROJO
    return f"{color}{temp:.{decimales}f}{RESET}"

# =============================================================
# ESTADO COMPARTIDO
# =============================================================

_lock_gps = threading.Lock()
_estado_gps = {"gps_lat": None, "gps_lon": None, "gps_vel_kmh": None}

def guardar_gps(datos):
    with _lock_gps:
        _estado_gps.update(datos)

def leer_gps():
    with _lock_gps:
        return dict(_estado_gps)

_lock_neumaticos = threading.Lock()
_estado_neumaticos = {k: 0.0 for k in NEUMATICO_CAMPOS}   # sin dato del sensor → 0

def guardar_neumaticos(datos):
    with _lock_neumaticos:
        _estado_neumaticos.update(datos)

def leer_neumaticos():
    with _lock_neumaticos:
        return dict(_estado_neumaticos)

_lock_ecu = threading.Lock()
_estado_ecu = {
    "rpm": None, "tps": None, "afr": None,
    "temp_refrigerante": None, "temp_aire": None,
    "presion_aceite": None, "bateria_v": None,
}
_ultimo_ecu_ts = 0.0

# --- Filtro exponencial (EMA) para temp_refrigerante ---
# Se actualiza una vez por frame válido de la ECU. Usa el dt real entre frames,
# así la suavidad depende de TEMP_REFRIG_TAU_S y no de la tasa de llegada de datos.
_temp_refrig_filtrada = None
_temp_refrig_ts = 0.0

def _filtrar_temp_refrig(valor, ahora):
    global _temp_refrig_filtrada, _temp_refrig_ts
    if valor is None:
        return _temp_refrig_filtrada
    if TEMP_REFRIG_TAU_S <= 0 or _temp_refrig_filtrada is None:
        _temp_refrig_filtrada = valor          # primer dato (o filtro apagado): arranca en el valor leido
    else:
        dt = max(ahora - _temp_refrig_ts, 0.0)
        alpha = 1.0 - math.exp(-dt / TEMP_REFRIG_TAU_S)
        _temp_refrig_filtrada += alpha * (valor - _temp_refrig_filtrada)
    _temp_refrig_ts = ahora
    return _temp_refrig_filtrada

def guardar_ecu(datos):
    global _ultimo_ecu_ts
    ahora = time.perf_counter()
    with _lock_ecu:
        if "temp_refrigerante" in datos:
            datos = dict(datos)
            datos["temp_refrigerante"] = _filtrar_temp_refrig(datos["temp_refrigerante"], ahora)
        _estado_ecu.update(datos)
        _ultimo_ecu_ts = ahora

def leer_ecu_sticky():
    with _lock_ecu:
        return dict(_estado_ecu)

def ecu_esta_ok(timeout=ECU_OK_TIMEOUT_S):
    with _lock_ecu:
        ts = _ultimo_ecu_ts
    return ts > 0 and (time.perf_counter() - ts) < timeout

_lock_marcha = threading.Lock()
_marcha = 0

def guardar_marcha(valor):
    global _marcha
    with _lock_marcha:
        _marcha = int(valor)

def leer_marcha():
    with _lock_marcha:
        return _marcha

# --- Estado STICKY del STM32 (Aislado por canal) ---
_lock_stm = threading.Lock()
_estado_stm_sticky = {k: None for k in STM_CAMPOS}
_fallos_consecutivos_stm = {k: 0 for k in STM_CAMPOS}
MAX_FALLOS_STICKY = 25  # 25 ciclos @ 25 Hz = 1 segundo de fallas antes de declarar sensor muerto

STM_LIMITES = {
    "angulo":       {"min": -4500,  "max": 4500,  "delta_max": 200},   # ° volante
    "acel_lateral": {"min": -10,   "max": 10,   "delta_max": 5},     # g
    "acel_x":       {"min": -16,   "max": 16,   "delta_max": 80},     # g
    "acel_y":       {"min": -16,   "max": 16,   "delta_max": 80},     # g
    "acel_z":       {"min": -16,   "max": 16,   "delta_max": 80},     # g
    "giro_x":       {"min": -2000, "max": 2000, "delta_max": 1000},  # °/s
    "giro_y":       {"min": -2000, "max": 2000, "delta_max": 1000},  # °/s
    "giro_z":       {"min": -2000, "max": 2000, "delta_max": 1000},  # °/s
    "dx1":          {"min": 0,     "max": 150,  "delta_max": 60},    # mm
    "dx2":          {"min": 0,     "max": 150,  "delta_max": 60},    # mm
    "dx3":          {"min": 0,     "max": 150,  "delta_max": 60},    # mm
    # --- Nuevas validaciones ---
    "marcha":       {"min": 0,     "max": 6,    "delta_max": 2},     # 0 (Neutro) a 6ª
    "stm_presion1": {"min": 0.0,   "max": 2000.0, "delta_max": 1200.0}, # PSI
    "stm_presion2": {"min": 0.0,   "max": 2000.0, "delta_max": 1200.0}, # PSI
}






def _sensor_valido(campo, val, prev):
    """Evalúa plausibilidad física de un sensor individual."""
    lim = STM_LIMITES.get(campo)
    if lim is None:
        return True  # Campos sin restricciones explícitas (marcha, presiones)

    if val is None:
        return False

    if not (lim["min"] <= val <= lim["max"]):
        return False

    if prev is not None and abs(val - prev) > lim["delta_max"]:
        return False

    return True

def guardar_stm(datos):
    """Actualiza canal por canal. Si un sensor falla, se preserva el resto."""
    global _fallos_consecutivos_stm
    with _lock_stm:
        for campo, val in datos.items():
            if campo not in _estado_stm_sticky:
                continue
            prev = _estado_stm_sticky.get(campo)
            if _sensor_valido(campo, val, prev):
                _estado_stm_sticky[campo] = val
                _fallos_consecutivos_stm[campo] = 0
            else:
                _fallos_consecutivos_stm[campo] += 1
                if _fallos_consecutivos_stm[campo] > MAX_FALLOS_STICKY:
                    _estado_stm_sticky[campo] = None

def leer_stm_sticky():
    with _lock_stm:
        return dict(_estado_stm_sticky)

# --- Estadísticas para la consola de debug ---
_lock_stats = threading.Lock()
_stats = {
    "n_muestras": 0,       # ciclos del loop principal
    "n_stm_fail": 0,       # lecturas SPI fallidas (total, suma de las causas de abajo)
    "n_csv_perdidas": 0,   # filas descartadas por cola CSV llena
    # --- Diagnóstico SPI: por qué falla cada lectura ---
    "fail_sync": 0,        # no hay ningún 0xAA en toda la ventana de 124 bytes
    "fail_sync_corrido": 0,  #   (no se usa más; se deja para no romper la consola)
    "fail_chk": 0,         # hay 0xAA pero ninguna trama de 62 bytes con checksum correcto
    "fail_cnt": 0,         # checksum OK pero contador inicial != final
    "fail_unpack": 0,      # struct.unpack falló (no debería pasar con 62 bytes)
    "desfase_recuperado": 0,  # trama válida encontrada con offset > 0 (antes habría sido un fallo)
    "spi_reabiertos": 0,   # veces que se cerró y reabrió el dispositivo SPI por fallos seguidos
    # --- Continuidad del contador de muestra del STM (solo tramas válidas) ---
    "cnt_repetido": 0,     # mismo contador que la lectura válida anterior (STM congelado o buffer no renovado)
    "cnt_salto": 0,        # el contador avanzó más de STM_DELTA_CNT_MAX (se perdieron muestras en el medio)
}

def incrementar_stat(campo, delta=1):
    with _lock_stats:
        _stats[campo] += delta

def leer_stats():
    with _lock_stats:
        return dict(_stats)

# Última trama SPI fallida (para mostrar en consola): (tipo, primeros bytes en hex)
_lock_ultimo_fallo = threading.Lock()
_ultimo_fallo_spi = None

def registrar_fallo_spi(tipo, raw):
    """Cuenta el fallo y guarda la trama para mostrarla / volcarla a archivo."""
    global _ultimo_fallo_spi
    incrementar_stat("n_stm_fail")
    incrementar_stat(tipo)
    cabecera = raw[:SPI_DUMP_BYTES_CONSOLA].hex(' ')
    with _lock_ultimo_fallo:
        _ultimo_fallo_spi = (tipo, cabecera)
    if SPI_DUMP_FALLOS:
        _volcar_fallo_spi(tipo, raw)

def leer_ultimo_fallo_spi():
    with _lock_ultimo_fallo:
        return _ultimo_fallo_spi

_n_dumps_spi = 0

def _volcar_fallo_spi(tipo, raw):
    """Agrega la trama completa (hex) al archivo de fallos. Tope SPI_DUMP_MAX para no llenar el disco."""
    global _n_dumps_spi
    if _n_dumps_spi >= SPI_DUMP_MAX:
        return
    _n_dumps_spi += 1
    try:
        with open(SPI_DUMP_NOMBRE, 'a') as f:
            f.write(f"{time.time():.3f} {tipo} {raw.hex(' ')}\n")
    except OSError:
        pass

# --- Estado Display Consola ---
_lock_display = threading.Lock()
_ultimo_estado_display = None

def actualizar_display(estado):
    global _ultimo_estado_display
    with _lock_display:
        _ultimo_estado_display = estado

def leer_estado_display():
    with _lock_display:
        return _ultimo_estado_display

# =============================================================
# ECU — protocolo serial propietario
# =============================================================

def _checksum_ecu(trama):
    return struct.pack('<I', sum(trama) & 0xFFFFFFFF)

def _armar_pedido_ecu(cmd):
    n = 10
    base = ECU_HEADER + bytes([cmd[0], cmd[1], cmd[2], n]) + ECU_FOOTER
    chk = _checksum_ecu(base)
    return bytearray(ECU_HEADER + bytes([cmd[0], cmd[1]]) + chk + bytes([cmd[2], n]) + ECU_FOOTER)

def _decodificar_ecu(payload):
    try:
        rpm        = struct.unpack_from('>h', payload, 8)[0]
        afr        = struct.unpack_from('B',  payload, 10)[0] / 10.0
        tps        = struct.unpack_from('>h', payload, 14)[0] / 10.0
        temp_motor = struct.unpack_from('>h', payload, 18)[0] / 10.0
        temp_aire  = struct.unpack_from('>h', payload, 20)[0] / 10.0
        vbat       = struct.unpack_from('>h', payload, 22)[0] / 100.0
    except struct.error:
        return None
    return {
        "rpm": rpm, "tps": tps, "afr": afr,
        "temp_refrigerante": temp_motor, "temp_aire": temp_aire,
        "presion_aceite": 0,
        "bateria_v": vbat,
    }

def hilo_ecu(stop):
    ser = None
    intentos = 0
    while ser is None and not stop.is_set():
        try:
            ser = serial.Serial(ECU_PUERTO, ECU_BAUDRATE, timeout=0)
            ser.reset_input_buffer()
            ser.reset_output_buffer()
        except Exception as e:
            intentos += 1
            if intentos == 1 or intentos % 10 == 0:
                print(f"[ECU] No se pudo abrir {ECU_PUERTO} (intento {intentos}): {e} — reintentando...")
            time.sleep(ECU_RETRY_ESPERA)

    if stop.is_set():
        return

    print(f"[ECU] Conectado en {ECU_PUERTO} @ {ECU_BAUDRATE} baud")

    try:
        ser.write(_armar_pedido_ecu([0, 0, 0]))
        time.sleep(0.05)
        ser.reset_input_buffer()
        print("[ECU] Handshake OK")
    except Exception as e:
        print(f"[ECU] Error en handshake: {e}")

    pedido = _armar_pedido_ecu([6, 0, 0])
    buffer = bytearray()
    ultimo = 0.0
    ultimo_frame_ok = time.perf_counter()

    while not stop.is_set():
        try:
            ahora = time.perf_counter()

            if ahora - ultimo >= ECU_PERIODO_S:
                ser.write(pedido)
                ultimo = ahora

            n = ser.in_waiting
            if n:
                buffer.extend(ser.read(n))

            hubo_frame = False
            while ECU_HEADER in buffer and ECU_FOOTER in buffer:
                ini = buffer.find(ECU_HEADER)
                fin = buffer.find(ECU_FOOTER, ini)
                if ini == -1 or fin == -1:
                    break
                trama  = buffer[ini: fin + 2]
                buffer = buffer[fin + 2:]

                if len(trama) > 12 and trama[2] == 180:
                    datos = _decodificar_ecu(trama[10:-2])
                    if datos:
                        guardar_ecu(datos)
                        hubo_frame = True

            if hubo_frame:
                ultimo_frame_ok = ahora

            if len(buffer) > ECU_BUFFER_MAX:
                print(f"[ECU] Buffer > {ECU_BUFFER_MAX} bytes sin sync, purgando...")
                buffer.clear()
                ultimo_frame_ok = ahora
            elif (ahora - ultimo_frame_ok) > ECU_RESYNC_TIMEOUT_S and len(buffer) > 0:
                print(f"[ECU] Sin frames válidos hace {ECU_RESYNC_TIMEOUT_S:.0f}s, purgando...")
                buffer.clear()
                ultimo_frame_ok = ahora

            time.sleep(0.001)

        except serial.SerialException as e:
            print(f"[ECU] Puerto perdido: {e} — reintentando...")
            buffer.clear()
            time.sleep(3.0)
            try:
                ser.close()
                ser.open()
                ser.reset_input_buffer()
                print("[ECU] Reconectado OK")
            except Exception as e2:
                print(f"[ECU] Reconexión fallida: {e2}")

        except Exception as e:
            print(f"[ECU] Error inesperado: {e}")
            buffer.clear()
            time.sleep(0.1)

    if ser and ser.is_open:
        ser.close()
    print("[ECU] Puerto cerrado.")

# =============================================================
# STM32 — lectura SPI
# =============================================================

_lock_cmd = threading.Lock()
_cmds_pendientes = deque()   # elementos: [cmd, param, repeticiones_restantes]

def enviar_comando_stm(cmd, param=0, repeticiones=3):
    """Encola un comando para el STM32. Sale en las próximas tramas de lectura (sin perder muestras).
    Se repite 'repeticiones' veces por si una trama se corrompe; los comandos son idempotentes."""
    with _lock_cmd:
        _cmds_pendientes.append([cmd, param, repeticiones])

def _tomar_comando():
    with _lock_cmd:
        if not _cmds_pendientes:
            return None
        item = _cmds_pendientes[0]
        item[2] -= 1
        if item[2] <= 0:
            _cmds_pendientes.popleft()
        return item[0], item[1]

def _armar_tx(cmd=None, param=0):
    """Sin comando: todo ceros (como antes). Con comando: bytes 0..6 = 0x55, código, int32, checksum."""
    tx = [0x00] * STM32_TAM_LECTURA
    if cmd is not None:
        raw = bytes([cmd]) + struct.pack('<i', param)     # código + parámetro (5 bytes)
        chk = 0
        for b in raw:
            chk ^= b
        tx[0:7] = [0x55] + list(raw) + [chk]
    return tx

_cnt_stm_prev = None   # contador de la última trama válida (solo lo usa el loop principal)

def _buscar_trama(raw):
    """Busca en la ventana de 124 bytes una trama completa y válida de 62 bytes.
    Devuelve (trama, offset, motivo). Si no hay ninguna: (None, -1, 'fail_sync' | 'fail_chk' | 'fail_cnt').
    El checksum es obligatorio: 0xAA también puede aparecer dentro de los floats."""
    motivo = "fail_sync"
    ultimo = len(raw) - STM32_TAM_PKT
    i = raw.find(STM32_SYNC)
    while i != -1 and i <= ultimo:
        t = raw[i:i + STM32_TAM_PKT]
        chk = 0
        for b in t[1:-1]:
            chk ^= b
        if chk == t[-1]:
            if t[1:3] == t[59:61]:          # contador inicial == contador final
                return t, i, None
            motivo = "fail_cnt"
        elif motivo == "fail_sync":
            motivo = "fail_chk"
        i = raw.find(STM32_SYNC, i + 1)
    return None, -1, motivo

def leer_stm32(spi):
    global _cnt_stm_prev
    # Una única transacción SPI: CS baja, viajan 124 bytes continuos, CS sube
    c = _tomar_comando()
    try:
        raw = bytes(spi.xfer2(_armar_tx(*c) if c else _armar_tx()))
    except OSError:
        registrar_fallo_spi("fail_sync", bytes(8))   # error del driver SPI: cuenta como lectura fallida
        return None

    # 1. Buscar una trama válida dentro de la ventana (sync + checksum + contadores)
    trama, offset, motivo = _buscar_trama(raw)
    if trama is None:
        registrar_fallo_spi(motivo, raw)
        return None
    if offset > 0:
        incrementar_stat("desfase_recuperado")

    # 2. Desempaquetado de datos
    try:
        (n_ini,
         angulo, acel_lateral,
         ax, ay, az, gx, gy, gz,
         dx1, dx2, dx3,
         presion1, presion2,
         cambio,
         n_fin) = struct.unpack_from(STM32_FORMATO, trama, 1)
    except struct.error:
        registrar_fallo_spi("fail_unpack", raw)
        return None

    # 5. Continuidad del contador entre tramas válidas (uint16, con wrap)
    if _cnt_stm_prev is not None:
        delta = (n_ini - _cnt_stm_prev) & 0xFFFF
        if delta == 0:
            incrementar_stat("cnt_repetido")
        elif delta > STM_DELTA_CNT_MAX:
            incrementar_stat("cnt_salto")
    _cnt_stm_prev = n_ini

    return {
        "marcha": cambio, "angulo": angulo, "acel_lateral": acel_lateral,
        "acel_x": ax, "acel_y": ay, "acel_z": az,
        "giro_x": gx, "giro_y": gy, "giro_z": gz,
        "dx1": dx1, "dx2": dx2, "dx3": dx3,
        "stm_presion1": presion1, "stm_presion2": presion2,
    }

# =============================================================
# GPS / CAN RX
# =============================================================

def _decodificar_gps_latlon(data):
    lat = struct.unpack_from('>i', data, 0)[0] * 1e-7
    lon = struct.unpack_from('>i', data, 4)[0] * 1e-7
    return {"gps_lat": lat, "gps_lon": lon}

def _decodificar_gps_tiempo(data):
    # Speed: offset 4, 2 bytes (bytes usados 4-5), unsigned, big-endian real
    # (la tabla dice "Intel" pero el dato viene en big-endian), factor 0.1 km/h.
    velocidad_raw = struct.unpack_from('>H', data, 4)[0]
    return {"gps_vel_kmh": velocidad_raw * 0.1}

def _decodificador_neumatico(campo):
    """Fábrica: las 4 ruedas usan el mismo payload (2 bytes big-endian, escala 0.1 °C);
    solo cambia el campo donde se guarda. unpack_from lanza struct.error si el frame es corto."""
    def decode(data):
        raw = struct.unpack_from('>H', data, 0)[0]
        return {campo: raw / 10.0}
    return decode

# Cada CAN ID mapea a (función decodificadora, función que guarda el resultado)
CAN_RX_HANDLERS = {
    CAN_ID_GPS_LATLON:   (_decodificar_gps_latlon, guardar_gps),
    CAN_ID_GPS_TIEMPO:   (_decodificar_gps_tiempo, guardar_gps),
    CAN_ID_NEUMATICO_DI: (_decodificador_neumatico("temp_neumatico_di"), guardar_neumaticos),
    CAN_ID_NEUMATICO_DD: (_decodificador_neumatico("temp_neumatico_dd"), guardar_neumaticos),
    CAN_ID_NEUMATICO_TI: (_decodificador_neumatico("temp_neumatico_ti"), guardar_neumaticos),
    CAN_ID_NEUMATICO_TD: (_decodificador_neumatico("temp_neumatico_td"), guardar_neumaticos),
}

def hilo_can_rx(bus_can, stop):
    print("[CAN RX] Escuchando GPS y neumáticos (4 ruedas)...")
    while not stop.is_set():
        try:
            msg = bus_can.recv(timeout=0.1)
        except can.CanError:
            time.sleep(0.1)
            continue
        if msg is None:
            continue
        handler = CAN_RX_HANDLERS.get(msg.arbitration_id)
        if handler:
            decoder, guardar = handler
            try:
                guardar(decoder(bytes(msg.data)))
            except struct.error:
                # Frame con menos bytes de los esperados: se descarta y el hilo sigue vivo
                continue
    print("[CAN RX] Hilo detenido.")

# =============================================================
# CAN TX (Pantalla Cockpit)
# =============================================================

def _empaquetar_senal(payload, valor, sig):
    val = valor if valor is not None else 0
    raw = int((val + sig['add']) * sig['div'] * sig['mult']) & sig['mask']
    if sig['len'] == 1:
        payload[sig['off']] = raw & 0xFF
    elif sig['len'] == 2:
        payload[sig['off']]     = (raw >> 8) & 0xFF
        payload[sig['off'] + 1] =  raw        & 0xFF
    return payload

def enviar_can(bus_can, ecu, marcha):
    def enviar(can_id, señales):
        payload = [0] * 8
        for valor, sig in señales:
            _empaquetar_senal(payload, valor, sig)
        bus_can.send(can.Message(arbitration_id=can_id, data=payload, is_extended_id=False))

    datos_ecu = {
        'rpm': 0, 'tps': 0, 'afr': 0, 'temp_refrigerante': 0,
        'temp_aire': 0, 'bateria_v': 0, 'presion_aceite': 0
    }
    if ecu is not None:
        datos_ecu.update(ecu)

    enviar(CAN_ID_MOTOR,       [(datos_ecu['rpm'], SIG_RPM), (datos_ecu['tps'], SIG_TPS)])
    enviar(CAN_ID_TEMPS,       [(datos_ecu['temp_refrigerante'], SIG_TEMP_REFRIG),
                                (datos_ecu['temp_aire'], SIG_TEMP_AIRE),
                                (datos_ecu['bateria_v'], SIG_BATERIA)])
    enviar(CAN_ID_PRES_ACEITE, [(datos_ecu['presion_aceite'], SIG_PRES_ACEITE)])
    enviar(CAN_ID_MARCHA,      [(marcha, SIG_MARCHA)])
    enviar(CAN_ID_LAMBDA,      [(datos_ecu['afr'], SIG_LAMBDA)])

def hilo_can_tx(bus_can, stop):
    print("[CAN TX] Iniciado a 10 Hz...")
    while not stop.is_set():
        inicio = time.perf_counter()
        ecu = leer_ecu_sticky()
        marcha = leer_marcha()
        try:
            enviar_can(bus_can, ecu, marcha)
        except can.CanError:
            pass

        dt = time.perf_counter() - inicio
        resto = CAN_TX_PERIODO_S - dt
        if resto > 0:
            time.sleep(resto)
    print("[CAN TX] Hilo detenido.")

# =============================================================
# CSV & CONSOLA LOCAL
# =============================================================

def hilo_csv(cola_csv, stop):
    print(f"[CSV] Guardando sesión en: {CSV_NOMBRE}")
    with open(CSV_NOMBRE, mode='w', newline='') as f:
        writer = csv.DictWriter(f, fieldnames=CSV_COLUMNAS)
        writer.writeheader()
        ultimo_fsync = time.perf_counter()

        while not stop.is_set() or not cola_csv.empty():
            try:
                fila = cola_csv.get(timeout=0.1)
                writer.writerow(fila)
                ahora = time.perf_counter()
                if ahora - ultimo_fsync >= FSYNC_CADA_S:
                    f.flush()
                    os.fsync(f.fileno())
                    ultimo_fsync = ahora
            except queue.Empty:
                continue
        f.flush()
        os.fsync(f.fileno())
    print("[CSV] Archivo cerrado.")

def mostrar_consola(estado):
    stats    = leer_stats()
    n_muest  = stats['n_muestras']
    n_fail   = stats['n_stm_fail']
    n_perd   = stats['n_csv_perdidas']
    tasa_err = (n_fail / n_muest * 100) if n_muest else 0.0

    marcha = NOMBRES_MARCHA.get(estado.get('marcha'), str(estado.get('marcha')))
    ecu_ok = estado.get('ecu_ok', False)

    c_err = VERDE if tasa_err < 1 else (AMARILLO if tasa_err < 5 else ROJO)
    c_ecu = VERDE if ecu_ok else ROJO

    print(CLEAR, end="") 
    print(f"{BOLD}{CYAN}{'='*56}{RESET}")
    print(f"{BOLD}{CYAN}   TELEMETRÍA — STM32 + ECU + GPS{RESET}")
    print(f"{CYAN}{'='*56}{RESET}")
    print(f"\n  {BOLD}Muestra #{n_muest:<6}{RESET}  t_PC={estado.get('tiempo_pc_ms', 0):.1f} ms\n")

    print(f"  {'Marcha':<22}  {marcha:>10}")
    print(f"  {'Ángulo volante':<22}  {_fmt(estado.get('angulo'), 1)}  °")
    print(f"  {'Acel. lateral':<22}  {_fmt(estado.get('acel_lateral'), 3)}  g")
    print(f"  {'Acel X/Y/Z':<22}  {_fmt(estado.get('acel_x'), 2)} {_fmt(estado.get('acel_y'), 2)} {_fmt(estado.get('acel_z'), 2)}")
    print(f"  {'Giro X/Y/Z':<22}  {_fmt(estado.get('giro_x'), 2)} {_fmt(estado.get('giro_y'), 2)} {_fmt(estado.get('giro_z'), 2)}")
    print(f"  {'dx1':<22}  {_fmt(estado.get('dx1'), 1)}  mm")
    print(f"  {'dx2':<22}  {_fmt(estado.get('dx2'), 1)}  mm")
    print(f"  {'dx3':<22}  {_fmt(estado.get('dx3'), 1)}  mm")
    print(f"  {'Presión 1 (STM)':<22}  {_fmt(estado.get('stm_presion1'), 1)}")
    print(f"  {'Presión 2 (STM)':<22}  {_fmt(estado.get('stm_presion2'), 1)}")

    print(f"  {'RPM':<22}  {_fmt(estado.get('rpm'), 0)}  rpm")
    print(f"  {'TPS':<22}  {_fmt(estado.get('tps'), 1)}  %")
    print(f"  {'AFR':<22}  {_fmt(estado.get('afr'), 1)}")
    print(f"  {'Temp. refrigerante':<22}  {_fmt(estado.get('temp_refrigerante'))}  °C")
    print(f"  {'Temp. aire':<22}  {_fmt(estado.get('temp_aire'))}  °C")
    print(f"  {'Presión aceite':<22}  {_fmt(estado.get('presion_aceite'), 0)}")
    print(f"  {'Batería':<22}  {_fmt(estado.get('bateria_v'), 2)}  V")
    print(f"  {c_ecu}{'ECU':<22}  {'OK' if ecu_ok else 'SIN DATOS'}{RESET}")

    print(f"  {'Latitud':<22}  {_fmt(estado.get('gps_lat'), 7)}  °")
    print(f"  {'Longitud':<22}  {_fmt(estado.get('gps_lon'), 7)}  °")
    print(f"  {'Velocidad':<22}  {_fmt(estado.get('gps_vel_kmh'))}  km/h")

    print(f"  {'Neumático DI':<22}  {_fmt_neumatico(estado.get('temp_neumatico_di'))}  °C")
    print(f"  {'Neumático DD':<22}  {_fmt_neumatico(estado.get('temp_neumatico_dd'))}  °C")
    print(f"  {'Neumático TI':<22}  {_fmt_neumatico(estado.get('temp_neumatico_ti'))}  °C")
    print(f"  {'Neumático TD':<22}  {_fmt_neumatico(estado.get('temp_neumatico_td'))}  °C")

    print(f"\n  Lecturas SPI fallidas: {c_err}{n_fail} ({tasa_err:.1f}%){RESET}")
    print(f"    sin 0xAA en ventana:   {stats['fail_sync']}")
    print(f"    checksum XOR:          {stats['fail_chk']}")
    print(f"    desfases recuperados:  {stats['desfase_recuperado']}   SPI reabierto: {stats['spi_reabiertos']}")
    print(f"    contador ini != fin:   {stats['fail_cnt']}")
    print(f"    unpack:                {stats['fail_unpack']}")
    print(f"    contador repetido:     {stats['cnt_repetido']}   saltos > {STM_DELTA_CNT_MAX}: {stats['cnt_salto']}")
    ultimo = leer_ultimo_fallo_spi()
    if ultimo:
        print(f"    {GRIS}última falla: {ultimo[0]}  [{ultimo[1]} ...]{RESET}")
    print(f"  CSV perdidos (cola llena): {n_perd}")
    print(f"\n  {GRIS}CSV → {CSV_NOMBRE}{RESET}")
    print(f"  {CYAN}Ctrl+C para detener{RESET}\n")

def hilo_consola(stop):
    while not stop.is_set():
        st = leer_estado_display()
        if st:
            mostrar_consola(st)
        time.sleep(DISPLAY_PERIODO_S)

# =============================================================
# LOOP PRINCIPAL
# =============================================================

def abrir_spi():
    """Abre y configura el dispositivo SPI. Lanza excepción si falla."""
    spi = spidev.SpiDev()
    spi.open(SPI_BUS, SPI_DEVICE)
    spi.max_speed_hz = SPI_VELOCIDAD
    spi.mode = SPI_MODO
    return spi

def reabrir_spi(spi):
    """Cierra y reabre el SPI. Devuelve el objeto nuevo, o el viejo si no se pudo."""
    try:
        spi.close()
    except Exception:
        pass
    try:
        nuevo = abrir_spi()
        incrementar_stat("spi_reabiertos")
        print("[SPI] Dispositivo reabierto tras fallos seguidos.")
        return nuevo
    except Exception as e:
        print(f"[SPI] No se pudo reabrir: {e}")
        return spi

def main():
    stop = threading.Event()
    cola_csv = queue.Queue(maxsize=1000)

    # 1. Configurar SPI
    try:
        spi = abrir_spi()
    except Exception as e:
        print(f"[ERROR] SPI init falló: {e}")
        return

    # 2. Configurar CAN
    try:
        bus_can = can.interface.Bus(channel=CAN_CANAL, bustype='socketcan', bitrate=CAN_BITRATE)
    except Exception as e:
        print(f"[ERROR] CAN init falló ({CAN_CANAL}): {e}")
        spi.close()
        return

    # 3. Iniciar Hilos
    t_ecu = threading.Thread(target=hilo_ecu, args=(stop,), daemon=True)
    t_can_rx = threading.Thread(target=hilo_can_rx, args=(bus_can, stop), daemon=True)
    t_can_tx = threading.Thread(target=hilo_can_tx, args=(bus_can, stop), daemon=True)
    t_csv = threading.Thread(target=hilo_csv, args=(cola_csv, stop), daemon=False)
    t_display = threading.Thread(target=hilo_consola, args=(stop,), daemon=True) if MOSTRAR_CONSOLA else None

    t_ecu.start()
    t_can_rx.start()
    t_can_tx.start()
    t_csv.start()
    if t_display is not None:
        t_display.start()

    print(f"[MAIN] Loop principal a {1.0/CICLO_S:.0f} Hz...")
    t_inicio_pc = time.perf_counter()
    fallos_seguidos = 0

    try:
        while True:
            t_ciclo = time.perf_counter()

            # Lectura SPI (con un reintento inmediato si falla)
            stm_datos = leer_stm32(spi)
            if stm_datos is None:
                time.sleep(SPI_REINTENTO_PAUSA_S)
                stm_datos = leer_stm32(spi)
            incrementar_stat("n_muestras")

            if stm_datos is not None:
                fallos_seguidos = 0
                guardar_stm(stm_datos)
                marcha_ok = leer_stm_sticky().get("marcha")
                if marcha_ok is not None:
                    guardar_marcha(marcha_ok)
            else:
                # (registrar_fallo_spi ya contó el fallo: no se vuelve a sumar acá)
                fallos_seguidos += 1
                if fallos_seguidos >= SPI_FALLOS_PARA_REABRIR:
                    spi = reabrir_spi(spi)
                    fallos_seguidos = 0

            # Consolidar datos
            stm_actual = leer_stm_sticky()
            ecu_actual = leer_ecu_sticky()
            gps_actual = leer_gps()
            neumaticos_actual = leer_neumaticos()

            tiempo_ms = int((time.perf_counter() - t_inicio_pc) * 1000)

            fila = {"tiempo_pc_ms": tiempo_ms}
            fila.update(stm_actual)
            fila.update(ecu_actual)
            fila.update(gps_actual)
            fila.update(neumaticos_actual)

            try:
                cola_csv.put_nowait(fila)
            except queue.Full:
                incrementar_stat("n_csv_perdidas")

            # Estado para la consola: la fila + info de diagnóstico (no va al CSV)
            if MOSTRAR_CONSOLA:
                estado_display = dict(fila)
                estado_display["ecu_ok"] = ecu_esta_ok()
                actualizar_display(estado_display)

            # Sincronización a 25 Hz
            dt = time.perf_counter() - t_ciclo
            resto = CICLO_S - dt
            if resto > 0:
                time.sleep(resto)

    except KeyboardInterrupt:
        print("\n[MAIN] Deteniendo sistema...")
        stop.set()
        t_csv.join(timeout=2.0)
        spi.close()
        bus_can.shutdown()
        print("[MAIN] Apagado limpio completado.")

if __name__ == "__main__":
    main()
