LautiDO/Electro-FiubaRacing/(commit log)

2025-07-19 Add codigos de prueba rapido, wide band
2025-08-11 Guardado de Memoria OK
2025-09-09 Subo el simulador de los sensores del motor, y el emulador de puerto usb para transmisión de datos continuos
2025-09-16 cambios menores a funcionamiento del sensor del aire
2025-09-16 Añadir funcionalidad de windows
2025-09-16 README y documentación para Linux
2025-09-16 Agregar documentación para Windows
2025-09-18 Implementación del resto de sensores, y funcionamiento de velocidad.
2025-09-18 Funcionamiento del resto de sensores, excepto F.suspension
2025-10-03 Cambio de formato en cada sensor
2025-10-10 modificado con boton el guardado de memoria
2025-10-16 modificado con la temperatura del motor
2025-11-07 andan temp motor, tps y mas o menos temp aire
2025-11-21 Update Purbe blue pill
    El codigo se dietiene si no detrecta la memoria
2025-12-11 codigo que lee rpm bien
2026-01-12 codigo que guarda en memoria, mide extensometros, mide rpm
2026-01-12 codigo imu
2026-02-03 Codigo encoder que anda, optico
2026-02-03 para sacar los datos del motor en la ecu
2026-03-27 agrega la parte de sincronizar si se corre
2026-03-27 anda bien como slave, pero no soluciona lo de la imu
2026-04-09 test_spi_raspi
    Prueba de la comunicaciones spi RASPI funcinando ok
2026-04-16 cableado lauti
2026-04-24 Nueva version v1.0
    Sript mejorado para la comunicacion CAN con la pantalla
    [config_can_bus.txt]
2026-04-24 Config del CAN bus
    [config_can_bus.txt]
2026-04-24 Toturiales Raspi
    [config_can_bus.txt]
2026-04-25 Repositorio ordenado
    [config_can_bus.txt]
2026-04-25 Integracion de bus CAN con los datos de la ECU
    Comunicaion CAN funcionando desde la Raspi
2026-04-27 add config
    [config_can_bus.txt]
2026-05-08 Codigo de los cambios que funciona con arduino y motor
2026-05-14 pcb version final con logo
2026-05-15 pcb que le mandamos al lci
2026-05-15 se agrego la funcion de los cambios
2026-05-15 Pantalla andando con valores cambiados de escalam
2026-05-17 v4 con las correcciones de lci
2026-05-21 se agrego la funcion de medir presion
2026-05-22 se agrego la medicion de la presion y de los cambios
2026-05-22 v4 de telemetria unificada, falta poner bateria
2026-06-30 Ord Repo
    [DAQ_rasp.kicad_pcb, DAQ_rasp.kicad_sch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]
2026-07-22 codigo que solo manda lo de los cambios y el tiempo
2026-07-22 version que recibe los cambios
2026-08-13 cambios y encoder
2026-08-17 modificaciones para el delay de la pantalla
2026-09-04 es el que va con telemetria_simple_v8
2026-09-06 modificacion logica de los cambios
2026-09-06 se agregó la parte del round para las cifras significativas
2026-09-18 se agrego la cuenta de la presion de frenos
2026-09-18 se arreglo el tema del com
2026-10-04 se agrego un filtro para la temp y flag consola
2026-10-22 version con correccion del spi
2026-10-28 pruebas fallidas de solucionar el ruido de arranque
